topherCantrell/PixelProp/(list of files, drawings)

Other design files:
PixelProp.pcb
