topherCantrell/PixelProp/(commit log)

2018-05-25 Initial checkin
    [PixelProp.pcb, PixelProp.sch]
2018-05-29 Finished ... hopefully
    [PixelProp.pcb, PixelProp.sch]
2018-05-31 Ordered boards
    [PixelProp.pcb, PixelProp.sch]
2018-05-31 Updated schematic
2018-06-19 Initial tests for board
2018-06-19 Renumbered pins for the PixelProp board
2020-03-21 populated all 4 boards
2020-04-05 Fixes for finding 1st sector
    [HardwareTest.spin, OreoTest.spin, Test.spin]
